thomaslr/MultiBand6-ESP32-AtomicBeacon/enclosure/enclosure_lid.png

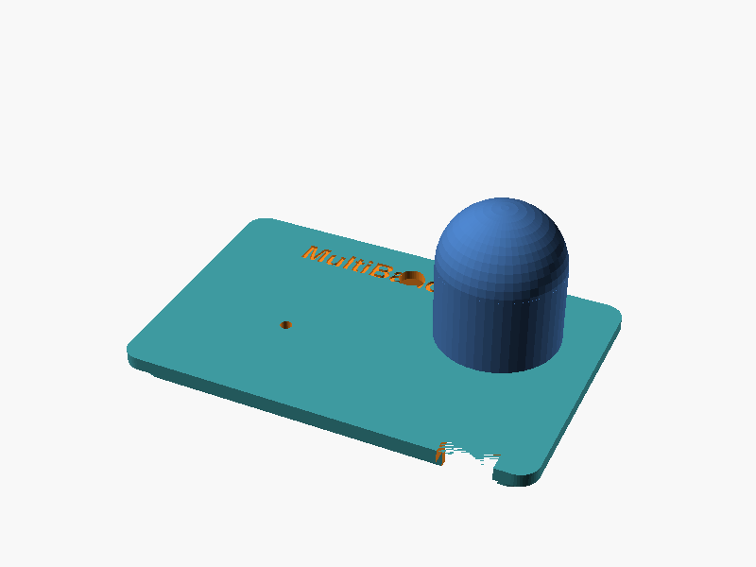
enclosure/enclosure_lid.png
