thomaslr/MultiBand6-ESP32-AtomicBeacon/enclosure/table_stand.png

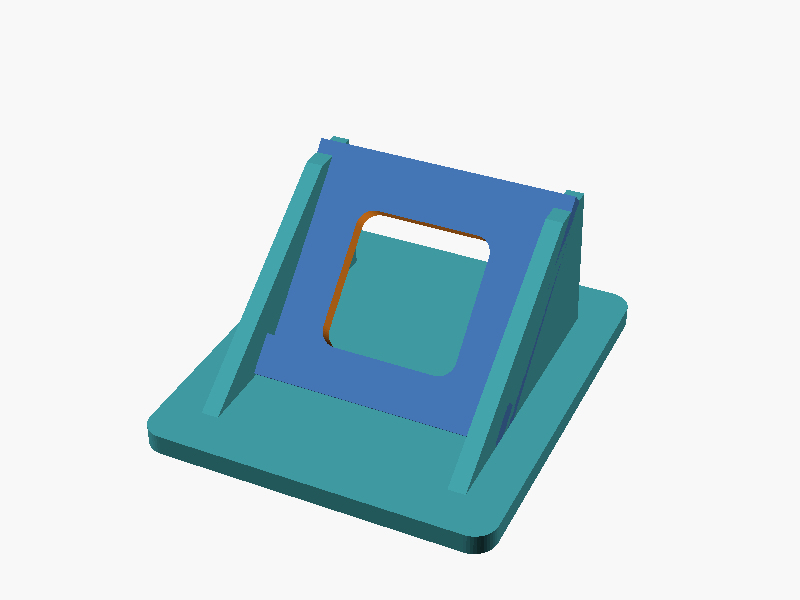
enclosure/table_stand.png
