thomaslr/MultiBand6-ESP32-AtomicBeacon/pcb/hole-through/MultiBand6_Beacon_THT_3D_Isometric.png

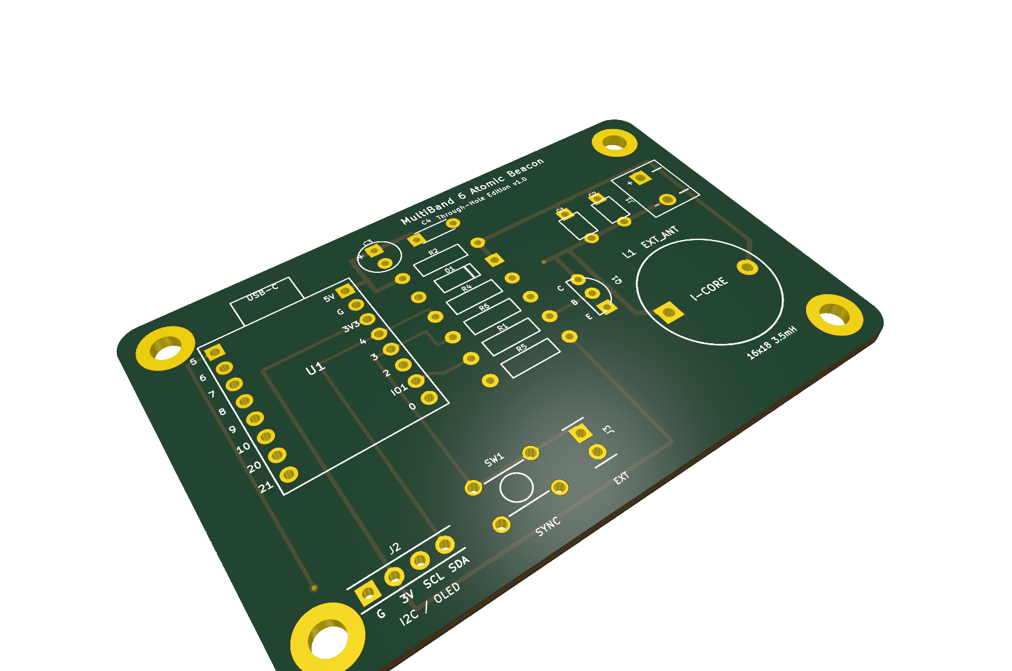
pcb/hole-through/MultiBand6_Beacon_THT_3D_Isometric.png
