thomaslr/MultiBand6-ESP32-AtomicBeacon/pcb/hole-through/MultiBand6_Beacon_THT_Top.png

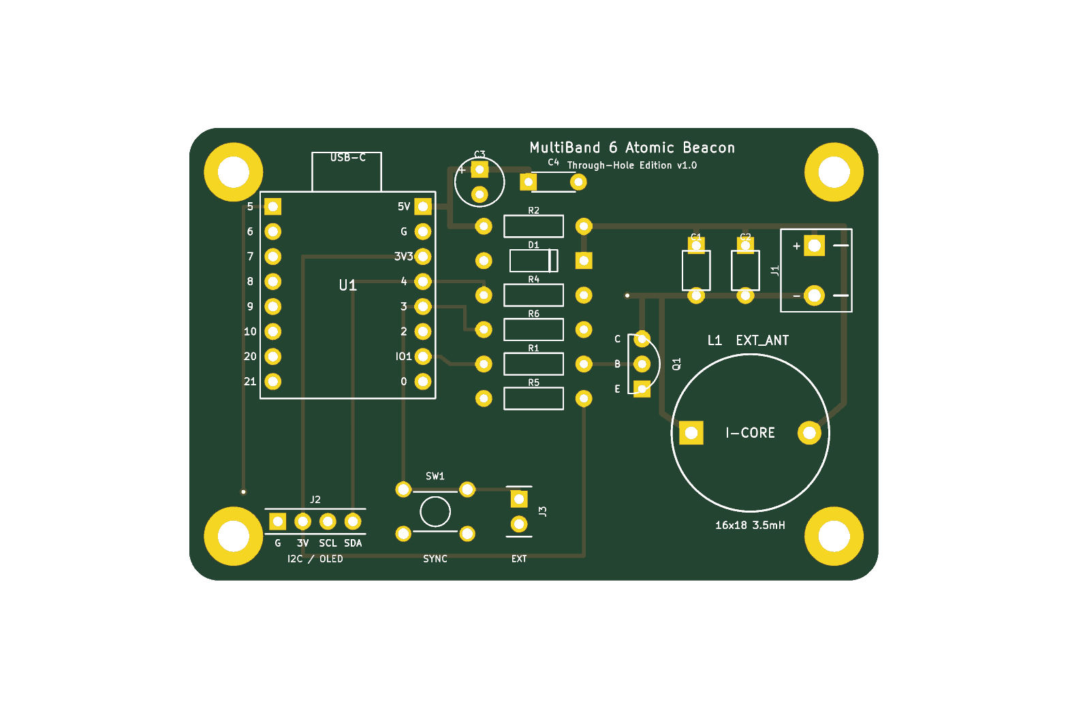
pcb/hole-through/MultiBand6_Beacon_THT_Top.png
