thomaslr/MultiBand6-ESP32-AtomicBeacon/pcb/smd/bom.csv

Comment | Designator | Footprint | LCSC Part # | Type
1k | R1 | R_0805_2012Metric | C17513 | Basic
220R | R2 | R_0805_2012Metric | C17557 | Basic
1.5nF 50V | C1 | C_0805_2012Metric | C1717 | Basic
10uF 25V | C3 | C_0805_2012Metric | C15850 | Basic
100nF 50V | C4 | C_0805_2012Metric | C49678 | Basic
MMBT2222A | Q1 | SOT-23 | C8512 | Basic
B5819W | D1 | D_SOD-123 | C8598 | Basic
4.7k | R4 | R_0805_2012Metric | C17673 | Basic
4.7k | R5 | R_0805_2012Metric | C17673 | Basic
10k | R6 | R_0805_2012Metric | C17414 | Basic
TS-1187A | SW1 | SW_Push_1P1T_XKB_TS-1187A | C318884 | Basic
