thomaslr/MultiBand6-ESP32-AtomicBeacon/enclosure/table_stand.stl

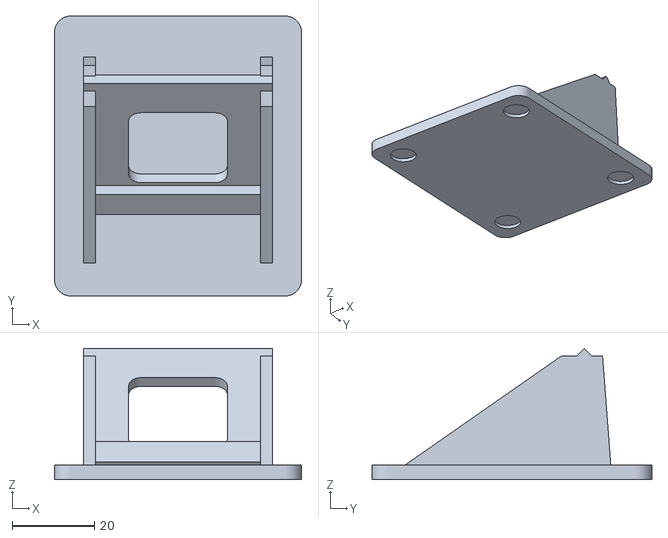
[picture p12: CAD file, 2026-11-09]
enclosure/table_stand.stl
60.0 x 68.0 x 31.8
