thomaslr/MultiBand6-ESP32-AtomicBeacon/enclosure/enclosure_base.stl

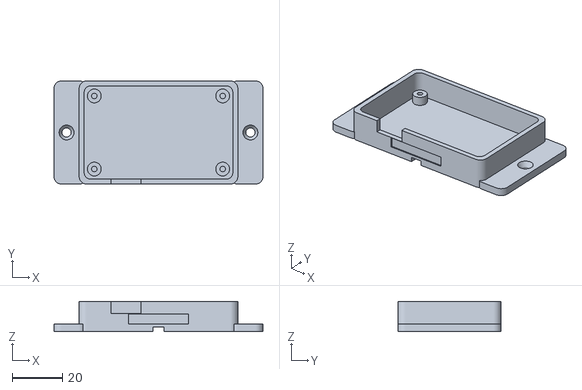
[picture p13: CAD file, 2026-11-09]
enclosure/enclosure_base.stl
83.0 x 41.0 x 12.0
