thomaslr/MultiBand6-ESP32-AtomicBeacon/enclosure/enclosure_lid.stl

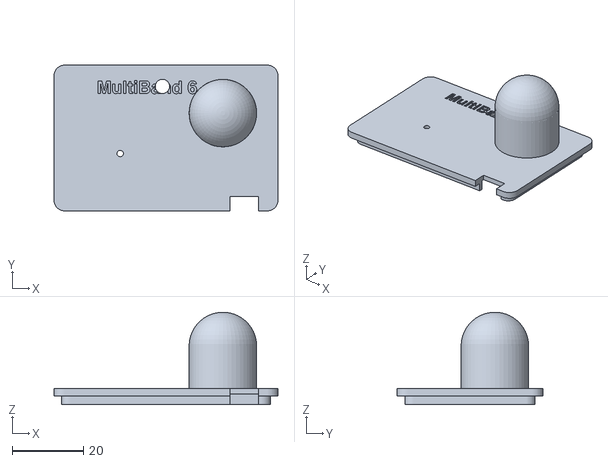
[picture p14: CAD file, 2026-11-09]
enclosure/enclosure_lid.stl
63.0 x 41.0 x 26.0
