thomaslr/MultiBand6-ESP32-AtomicBeacon/pcb/smd/MultiBand6_Beacon.kicad_pcb

## KiCad design pcb/smd/MultiBand6_Beacon.kicad_pcb (2026-11-10)

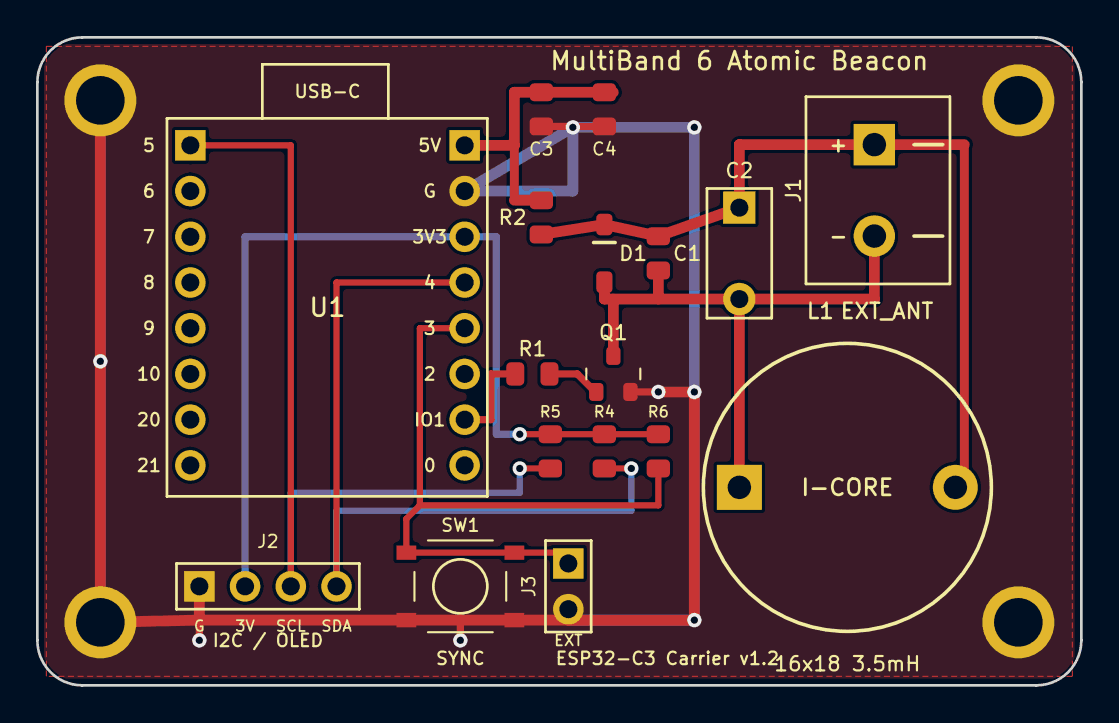
[picture p15: board MultiBand6_Beacon.kicad_pcb from above]

Board: 2 copper layers, 58.0 x 36.0 mm, 17 parts (0 on the bottom side), 10 nets.

Parts:
C1: 1.5nF; C_0805_2012Metric
C2: THT-CAP; C_Rect_L7.2mm_W3.5mm_P5.08mm
C3: 10uF; C_0805_2012Metric
C4: 100nF; C_0805_2012Metric
D1: B5819W; D_SOD-123
J1: ANT_EXT; TerminalBlock_bornier-2_P5.08mm
J2: I2C_OLED; PinHeader_1x04_P2.54mm_Vertical
J3: EXT_SYNC; PinHeader_1x02_P2.54mm_Vertical
L1: 16x18 3.5mH; L_Radial_D16.0mm_P12.0mm_16x18_I-Type
Q1: MMBT2222A; SOT-23
R1: 1k; R_0805_2012Metric
R2: 220R; R_0805_2012Metric
R4, R5: 4.7k; R_0805_2012Metric
R6: 10k; R_0805_2012Metric
SW1: TS-1187A; SW_Push_1P1T_XKB_TS-1187A
U1: ESP32-C3-SuperMini; ESP32-C3-SuperMini_Socket

Connections:
+3V3: J2.2, R4.1, R5.1, R6.1, U1.11
+5V: C3.1, C4.1, R2.1, U1.9
GND: C3.2, C4.2, J2.1, J3.2, Q1.2, SW1.2, U1.10
GPIO1_CARRIER: R1.1, U1.15
GPIO3: J3.1, R6.2, SW1.1, U1.13
GPIO4: J2.4, R4.2, U1.12
GPIO5: J2.3, R5.2, U1.1
NET_BASE: Q1.1, R1.2
NET_TANK_HI: C1.1, C2.1, D1.1, J1.1, L1.2, R2.2
NET_TANK_SW: C1.2, C2.2, D1.2, J1.2, L1.1, Q1.3
