thomaslr/MultiBand6-ESP32-AtomicBeacon/(commit log)

2026-10-06 Initial commit: MultiBand6-ESP32-AtomicBeacon firmware and hardware design
2026-10-06 feat: optimize low-power standby with modem sleep and non-blocking schedule
2026-10-06 docs: update README with default GPIO 2 pin, SuperMini pinout, and transistor booster circuit
2026-10-06 perf: maintain constant 80 MHz clock with hardware APB PWM and rail-stable broadcast
2026-10-06 feat: add ANTENNA_PIN support in .env and display active pin in web dashboard
2026-10-06 docs: correct ESP32-C3 SuperMini pinout with USB at top and top/bottom views
2026-10-06 docs: update breadboard SVG diagram to match corrected ESP32-C3 SuperMini pinout
2026-10-06 docs: place ESP32-C3 SuperMini directly on breadboard with 5V on F1 and organize components
2026-10-06 docs: update breadboard terminal row mapping in README to match on-board SuperMini mounting
2026-10-06 Add full grid of tie-point holes across all 24 breadboard rows
2026-10-07 Add gentle 4.0s breathing status LED on GPIO 8 during transmission
2026-10-07 Update title string to 'ESP32 Worldwide Radio Atomic Clock Simulator'
2026-10-07 feat: implement Multi-Station Carousel mode with dynamic hardware retuning
    - Add Multi-Station Carousel sequencer in src/main.cpp to rotate through multiple time stations (BPC, WWVB, JJY, MSF, DCF77)
    - Support clean minute-boundary handoff (:00 mark) to avoid truncated minute frames on watch receivers
    - Dynamically retune ESP32-C3 hardware LEDC carrier frequency on the fly
    - Add Carousel UI with station checklist and duration calculator in src/WebPage.h and web_preview.html
    - Provide live stage progress and countdown timers in web dashboard
    - Persist carousel enabled state, station mask, and stage duration in NVS preferences
    - Document Carousel mode in README.md
    [main.cpp]
2026-10-08 fix(ui): dynamically inject active antennaPin into info popover and specify 16x18 3.5mH I-type inductor
2026-11-08 feat(ui): implement metallic purple theme, PWA support, and unclipped Wi-Fi RF power controls
2026-11-08 fix(protocols): fix BPC P1 sub-frame index, JJY :15/:45 year/DOW, WWVB DST transition bits, and 50ms boundary lock (v0.1.2)
2026-11-10 fix(pcb): eliminate ground island and ensure full continuity across SMD, THT, and breadboard
2026-11-11 chore(release): bump firmware to v0.1.14 with 10s Wi-Fi heartbeat and 2s link-loss LED pulses
2026-11-12 fix(web): 1KB chunked HTTP streaming and multi-client socket LRU/SO_LINGER (v0.1.17)
